guillaumevirgal/autonomous-slam-robot/media/Nav2_2.png

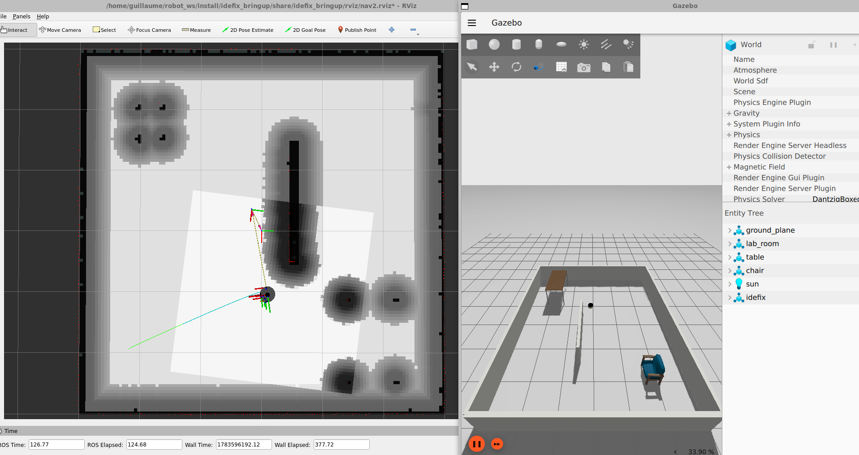
media/Nav2_2.png
