guillaumevirgal/autonomous-slam-robot/README.md

# autonomous-slam-robot
MSc Robotics summer project: an open-source autonomous mobile robot for SLAM, navigation, and perception. Target: HardwareX publication.
