guillaumevirgal/autonomous-slam-robot/media/Nav2_1.png

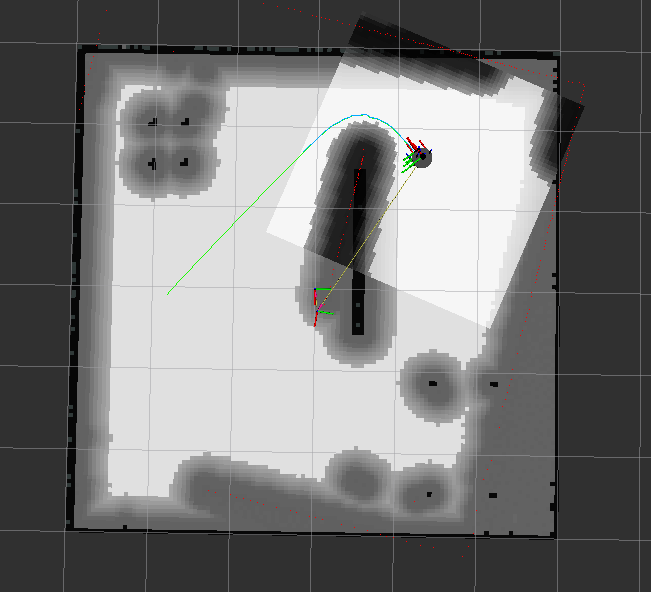
media/Nav2_1.png
