guillaumevirgal/autonomous-slam-robot/hardware/CAD/standoff.stl

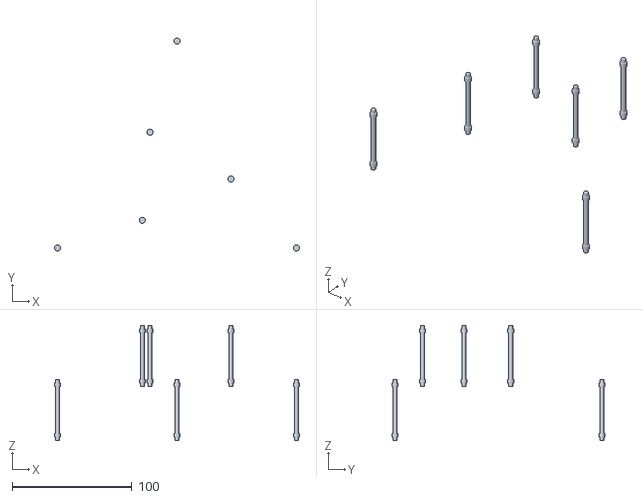
[picture p3: CAD file, 2026-08-01]
hardware/CAD/standoff.stl
204.3 x 177.6 x 96.0
