guillaumevirgal/autonomous-slam-robot/hardware/CAD/deck_3.stl

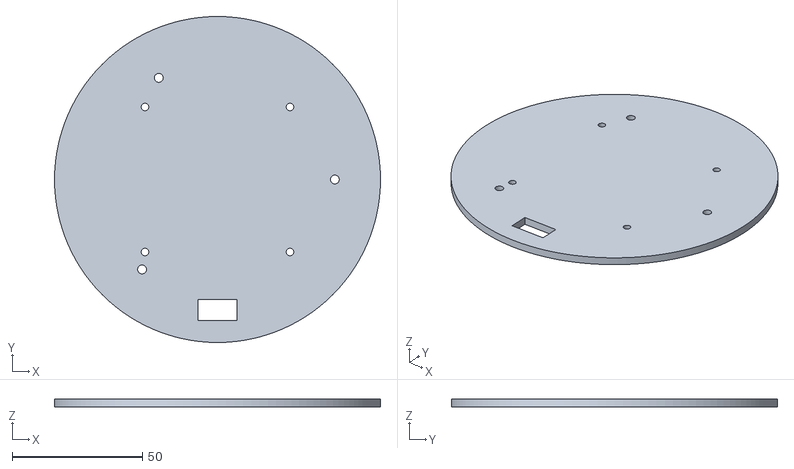
[picture p4: CAD file, 2026-08-01]
hardware/CAD/deck_3.stl
125.0 x 125.0 x 3.00
