guillaumevirgal/autonomous-slam-robot/hardware/CAD/deck_1.stl

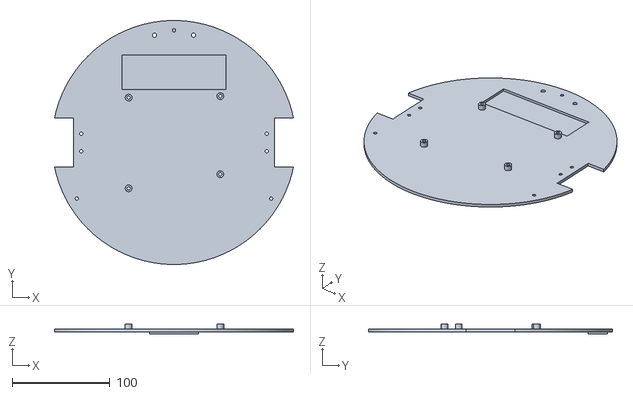
[picture p5: CAD file, 2026-08-01]
hardware/CAD/deck_1.stl
244.9 x 250.0 x 10.0
