guillaumevirgal/autonomous-slam-robot/hardware/CAD/deck_2.stl

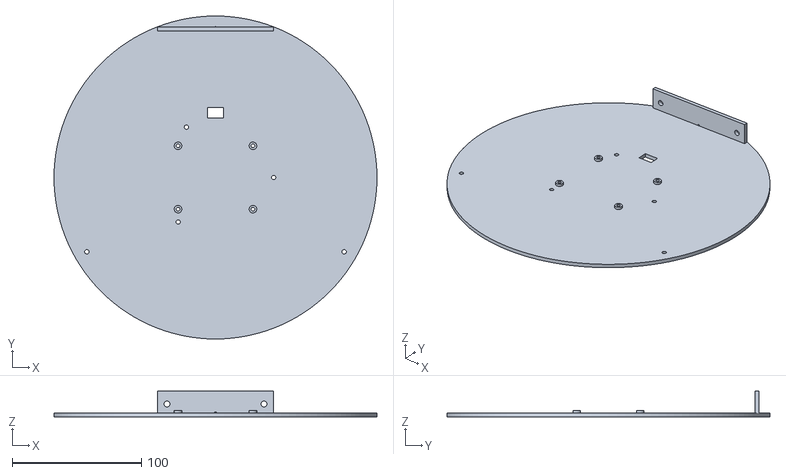
[picture p6: CAD file, 2026-08-01]
hardware/CAD/deck_2.stl
250.0 x 250.0 x 20.0
