guillaumevirgal/autonomous-slam-robot/hardware/PCB/Schematic_Summer-project-autonomous-slam-robot_2026-06-16.pdf

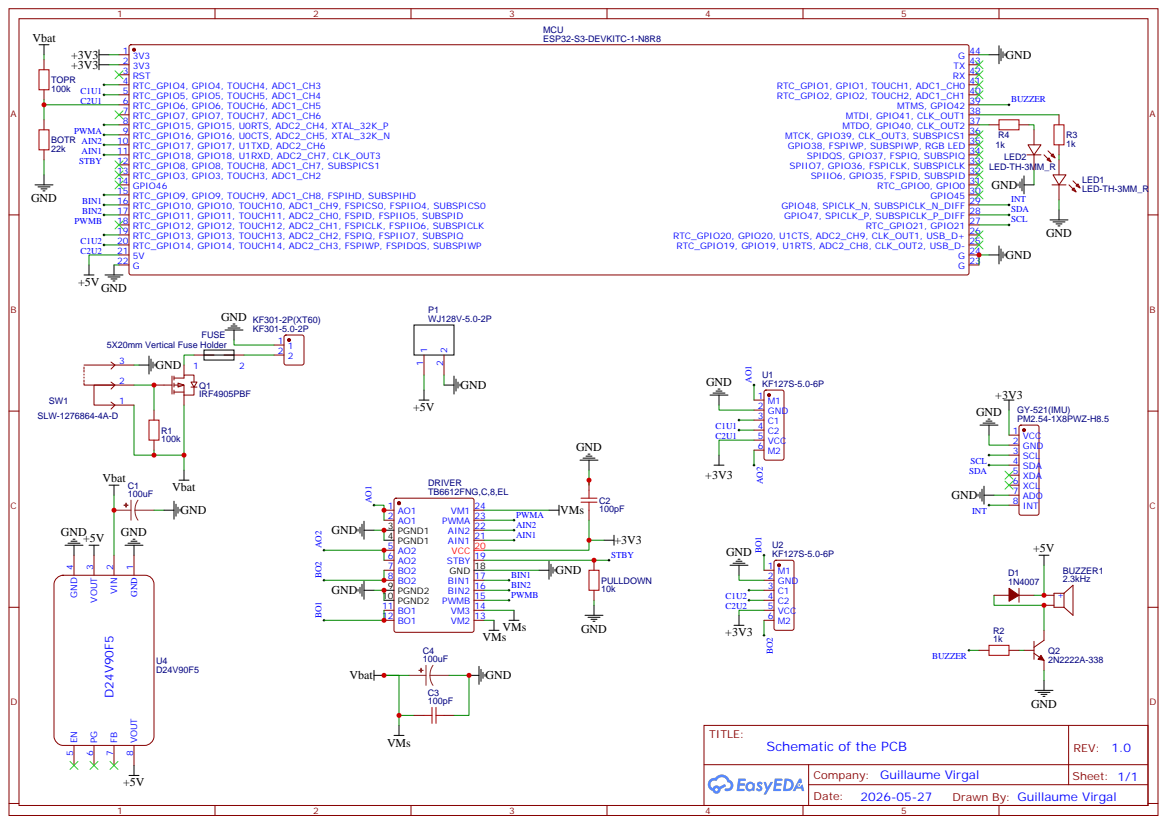
[picture p7: page 1]

MTCK, GPIO39, CLK_OUT3, SUBSPICS1 36
GPIO38, FSPIWP, SUBSPIWP, RGB LED 35
SPIDQS, GPIO37, FSPIQ, SUBSPIQ 34
SPIIO7, GPIO36, FSPICLK, SUBSPICLK 33
SPIIO6, GPIO35, FSPID, SUBSPID 32

Drawn By: Guillaume Virgal
