guillaumevirgal/autonomous-slam-robot/idefix_firmware/main/esp32_serial_transport.h

#ifndef _IDEFIX_ESP32_SERIAL_TRANSPORT_H_
#define _IDEFIX_ESP32_SERIAL_TRANSPORT_H_

#include <stdbool.h>
#include <stddef.h>
#include <stdint.h>

// Forward declaration to avoid pulling in the full micro-XRCE-DDS client header for callers who only need the function prototypes.
struct uxrCustomTransport;

#ifdef __cplusplus
extern "C"
{
#endif

bool   esp32_serial_open (struct uxrCustomTransport * transport);
bool   esp32_serial_close(struct uxrCustomTransport * transport);
size_t esp32_serial_write(struct uxrCustomTransport * transport, const uint8_t * buf, size_t len, uint8_t * err);
size_t esp32_serial_read (struct uxrCustomTransport * transport, uint8_t * buf, size_t len, int timeout, uint8_t * err);

#ifdef __cplusplus
}
#endif

#endif // _IDEFIX_ESP32_SERIAL_TRANSPORT_H_
