guillaumevirgal/autonomous-slam-robot/(commit log)

2026-07-09 Restructuration and add Idefix Phase 1: sim SLAM + Nav2 working, ROS2 packages, maps, media
    [idefix.gazebo.xacro, idefix.urdf.xacro, idefix_lab.sdf, idefix_world.sdf]
2026-08-01 hardware/CAD: OpenSCAD three-deck chassis and standoffs
    Parametric OpenSCAD sources for the circular differential-drive chassis:
    three PLA decks with standoff columns and pedestal for the caster ball.
    STL exports included so reviewers can print without regenerating.
    [Idefix.scad, common.scad, deck_1.scad, deck_1.stl, deck_2.scad, deck_2.stl, deck_3.scad, deck_3.stl]
2026-08-01 hardware/bench_tools: ESP32-C3 logic analyzer 24 MHz validation test
2026-08-01 idefix_firmware: ESP32-S3 firmware, Stage 1 open-loop motor characterization
    ESP-IDF project for the Idefix ESP32-S3-DevKitC-1-N8R8 firmware.
    Stage 1 open-loop motor characterization: PCNT quadrature encoder driver
    and TB6612FNG motor control, duty-sweep test rig.
    Awaiting replacement ESP32 module before re-verification.
    [encoder.c, encoder.h, main.c, motor.c, motor.h, pid.c, pid.h, pins.h]
2026-08-03 Nav2 Fortress -> harmonic migration
    [idefix.gazebo.xacro, idefix_lab.sdf, idefix_world.sdf]
2026-08-09 idefix_firmware: sign convention fixes for open-loop dual motor test
    - motor.c: Motor A invert_direction=true (mirror-symmetric wiring)
    - encoder.c: per-encoder invert parameter, encoder A invert=true
    Verified: positive duty produces positive measured velocity on both motors,
    magnitudes match Stage 1 baseline (2.7 rad/s +/- quantization dither).
    Ready for Stage 2 PID work.
    [encoder.c, main.c, motor.c]
2026-08-09 idefix_firmware: Stage 1 deadband ramp characterization
    25-step staircase, 0.01 duty per step, 2s per level, both motors
    commanded together. Full positive then negative ramp, 100s total.
    Deadband results (breakaway duty):
    - Motor A: +0.040 pos, -0.060 neg
    - Motor B: +0.060 pos, -0.060 neg
    Motor A slightly asymmetric (~20 mDuty). Both motors symmetric at
    cruise (duty >= 0.070). Steady-state at duty=0.15 matches Stage 1
    baseline (~2.75 rad/s). Max at duty=0.24 gives ~4.6 rad/s.
    One glitchy sample at t=89001 (-4491 rad/s spike) confirms need for
    Stage 2 moving-average filter before PID input.
    [main.c]
2026-08-14 idefix_firmware: vendor micro_ros_espidf_component (jazzy, 16cf0d5)
    Adds micro-ROS as a git submodule under components/ pinned to the jazzy
    branch at commit 16cf0d5. Enables Stage 3 (micro-ROS integration) to
    build against a reproducible micro-ROS + Micro XRCE-DDS stack cross-
    compiled for xtensa-esp32s3-elf inside the ESP-IDF build.
    Also commits:
    - dependencies.lock: resolved ESP-IDF component-manager dependencies,
    needed for reproducible builds.
    - sdkconfig: menuconfig state selecting 'micro-ROS over eProsima Micro
    XRCE-DDS' as middleware and 'Micro XRCE-DDS over UART' as network
    interface (defines CONFIG_MICRO_ROS_ESP_UART_TRANSPORT=y).
    Known submodule state: an in-tree edit to
    co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
2026-08-14 idefix_firmware: Stage 3 micro-ROS integration
    Full-rewrite of main.c to add micro-ROS on top of the working Stage 2
    PID loop, with a two-task FreeRTOS design that shares six stdatomic
    variables (setpoints uros->control, encoder snapshots control->uros)
    and no mutexes. control_task at 100 Hz on core 1 remains functionally
    identical to Stage 2; uros_task runs the micro-ROS executor on core 0.
    New source files:
    - esp32_serial_transport.c/h: custom UART transport for micro-ROS.
    Copied from int32_publisher_custom_transport example, modified to
    use UART GPIO pins from pins.h (GPIO 43/44 on ESP32-S3). Wired into the executor via rmw_uros_set_custom_transport
    in app_main.
    - robot_kinematics.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
2026-08-23 Adds odom_tf_broadcaster: subscribes to /odom (nav_msgs/Odometry) and publishes odom -> base_link on /tf via tf2_ros. Verified in isolation on WSL with a fake /odom publisher.
2026-08-25 firmware: micro-ROS serial link verified end to end
    - main.c: explicit rcl_init_options_set_domain_id(94);
    rmw_microxrcedds_c hardcodes domain to 0 regardless of CMake flags
    - app-colcon.meta: already set RMW_UXRCE_TRANSPORT=custom (pre-existing;
    now committed rather than lying around untracked)
    - sdkconfig: flash size 2MB -> 8MB to match N8R8 physical flash
    - .gitignore: exclude build.log
    Verified: /odom flows at 30.3 Hz, 19 ms stamp latency, live tf on
    hand-rotated wheels.
2026-09-01 idefix_bringup: RPLiDAR C1 bringup launch
    Adds launch/rplidar_c1.launch.py: starts the sllidar_ros2 driver node
    plus a static TF from base_link to laser. Publishes /scan at ~10 Hz,
    matching the C1's nominal scan rate.
    Driver: uses sllidar_ros2 (source build via submodule), not the
    originally planned ros-jazzy-rplidar-ros (apt, v2.1.0 is the only
    version available for Jazzy, not v2.1.4 as expected). The apt package
    reads generic device info (S/N, firmware, health) correctly but cannot
    start the C1's motor: scan-start consistently times out
    (RESULT_OPERATION_TIMEOUT) across every scan_mode/auto_standby
    combination and two different USB ports, and the motor was confirmed
    visually to never spin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
2026-09-23 idefix_firmware: IMU bring-up complete (GY-521/MPU6500, driver module, 100 Hz task, micro-ROS publish)
    Replaces the scratch I2C bring-up scan with a permanent imu.c/imu.h
    module mirroring motor.c/encoder.c: init (wake, WHO_AM_I, boot-time
    200-sample gyro bias calibration) and a read function returning
    physical units. A dedicated 100 Hz imu_task (core 0, priority 4)
    samples continuously; uros_task publishes sensor_msgs/Imu on
    /imu/data_raw via its own 100 Hz timer, matching the existing /odom
    pattern so only uros_task touches rcl_* calls. Removing the scratch
    code's infinite halt loop lets the rest of the firmware (motors,
    encoders, micro-ROS) boot normally again.
    Verified end to end on hard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
    [imu.c, imu.h, main.c]
2026-09-23 imu: raise FreeRTOS tick rate, switch /imu/data_raw to best-effort QoS
    Measured /imu/data_raw baseline was 78-84 Hz against the 100 Hz target,
    not the ~35 Hz previously assumed (that figure was stale, from before
    the prior commit's vTaskDelayUntil sampling fix landed). Root cause is
    two factors in uros_task's shared rclc executor (cmd_vel sub, odom
    timer, imu timer, one spin loop):
    1. CONFIG_FREERTOS_HZ was 100 (10 ms tick), so the executor spin
    loop's trailing vTaskDelay(pdMS_TO_TICKS(1)) rounded up to a full
    10 ms delay instead of 1 ms, capping the loop's own cadence.
    Raised to 1000 for 1 ms tick resolution. Measured effect alone:
    reduces period jitter tail, max period 27-29 m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
    [main.c]
2026-09-23 firmware: battery voltage sense (GPIO6/ADC1) + low-voltage buzzer (GPIO42)
    New battery.c/battery.h module, mirroring the existing motor.c/encoder.c/
    imu.c driver-per-file convention. Reads pack voltage over a resistor
    divider (100k top, 22k bottom) into ADC1 channel 5 (GPIO6), with
    per-chip calibration via adc_cali when available and a nominal
    3.3V/4095 fallback when not. Drives an active buzzer on GPIO42 directly
    (no PWM, the buzzer has its own oscillator).
    New battery_task (2 Hz, priority 2, lowest of the four tasks, core 0)
    polls voltage and applies hysteresis: buzzer on at or below 10.0V, off
    again only at or above 10.3V, to avoid chattering right at a single
    threshold from ordinary ADC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
    [battery.c, battery.h, main.c, pins.h]
2026-09-23 idefix_bringup: robot_localization EKF fusing /odom and /imu/data_raw
    New ekf.yaml + ekf.launch.py, launching robot_localization's ekf_node
    against the existing ament_python data_files globs (no setup.py change
    needed, launch/*launch.py and config/*.yaml already glob generically).
    Fuses body-frame velocities only, not pose: vx and vyaw from /odom, vyaw
    only from /imu/data_raw. Not fusing linear acceleration from the
    MPU6500 clone at this stage, it is noisy and uncalibrated. two_d_mode
    true (planar differential drive). process_noise_covariance left at
    defaults, tuning deferred until the fused estimate is stable.
    Correction to the original plan: it assumed firmware owned the
    odom -> base_lin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
    [ekf.yaml]
2026-09-23 idefix_firmware: best-effort cmd_vel QoS + micro-ROS agent retry
    Two independent fixes to main.c, found and applied during the Phase 3
    audit and SLAM mapping bringup.
    cmd_vel QoS: rclc_subscription_init_default (RELIABLE) is replaced with
    rclc_subscription_init_best_effort. The comment directly above the call
    already claimed best-effort ("matches teleop_twist_keyboard and Nav2
    defaults"); the code just never matched it.
    Agent handshake retry: RCCHECK on rclc_support_init_with_options called
    vTaskDelete(NULL) on failure, permanently killing uros_task with no
    retry. In practice this meant the micro-ROS agent had to already be
    running before the ESP32 booted, or the only way to get a fresh
    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
    [main.c]
2026-09-23 idefix_bringup + idefix_description: fix TF tree conflicts, scan yaw
    Two TF conflicts found and fixed while wiring up robot_state_publisher
    alongside the hardware LiDAR launch for the first time (previously
    never run together, so these were latent, not active, until now).
    base_footprint / base_link: odom_tf_broadcaster.py published
    odom -> base_link directly, but the URDF has base_footprint as
    base_link parent via a fixed joint (REP-105 pattern), so both were
    claiming to be base_link parent. Retargeted odom_tf_broadcaster.py to
    publish odom -> base_footprint instead. x/y/yaw are unaffected since
    they come straight from wheel-encoder odometry either way; only z
    differs between the two frames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
    [idefix.gazebo.xacro, idefix.urdf.xacro]
2026-09-23 idefix_bringup: hardware SLAM mapping launch
    Adds slam_mapping.launch.py and slam_toolbox_mapping.yaml: the LiDAR,
    robot_state_publisher, odom_tf_broadcaster, and slam_toolbox in
    mapping mode (as opposed to the existing slam_toolbox_localization.yaml,
    which is sim-era, localization mode, use_sim_time true, no map even
    configured). Mapping config values are adapted from the already-working
    sim slam_toolbox.yaml, changed to use_sim_time false.
    async_slam_toolbox_node turned out to be a lifecycle node in the
    installed version (2.8.5) even though it is the plain/non-Nav2
    executable. Launched as an ordinary Node it just sat unconfigured
    forever: zero subscriptions, no /map, no error, total silen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
2026-09-23 idefix_firmware: fix two cross-core races causing spurious /odom velocity spikes
    Found while diagnosing a rotation test that intermittently reported
    odom/filtered agreeing on rotation amounts wildly exceeding what was
    commanded (up to ~200% of a commanded 360 deg turn), with single /odom
    angular-velocity samples spiking to ~200-290 rad/s -- physically
    impossible for this drivetrain.
    1. main.c odom_timer_callback: the encoder snapshot (g_snapshot_counts_a,
    g_snapshot_counts_b, g_snapshot_time_us) was three independent atomics,
    written as a group by control_task and read as a group by
    odom_timer_callback, with a comment reasoning this was fine ("at worst
    ~10ms of temporal skew, in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
    [encoder.c, main.c]
2026-09-23 docs: bringup log for EKF deployment and left-wheel bolt diagnosis
    Starts docs/hardware_bringup.md (previously empty) with the first real
    hardware run of the robot_localization EKF: micro-ROS agent baud rate was
    stale (921600, not the documented 460800), a systemd-logind
    KillUserProcesses setting was reaping tmux/background processes between
    SSH sessions (fixed with loginctl enable-linger), and a rotation-test
    methodology for measuring commanded vs. achieved rotation via /odom and
    /odometry/filtered.
    Root-caused a reproducible ~50% rotation shortfall to the left wheel
    (Motor A) intermittently under-driving relative to the right wheel: for a
    pure in-place rotation both wheels normally contri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
2026-09-24 docs: bringup log for online SLAM + Nav2 on hardware
    Nav2 install on the Pi, slam_nav bringup verification, the use_sim_time
    override bug and its fix, and the open goal-following stall issue.
2026-09-24 idefix_firmware: stop double-counting PCNT overflows in encoder.c
    accum_count = true makes the ESP-IDF 5.3 PCNT driver accumulate +/-30000
    on each watch-point hit and return hw + accum_value from
    pcnt_unit_get_count(). The on_reach callback also added watch_point_value
    to a software accumulator, so every overflow was counted twice: a
    permanent 30000-count (~0.99 m) jump on one wheel each time its net count
    crossed +/-30000. This is the ~200-290 rad/s /odom spike and ~132 deg pose
    jump (30000 counts -> 8.585 rad -> 131.9 deg wrapped).
    Drop the callback and software accumulator and return the driver's
    extended count. Verified on hardware: two 4-turn spins crossing an
    overflow, odom 99.2% of c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
2026-09-24 docs: root cause of the /odom spike (PCNT overflow double count)
    Evidence from the slam_nav bag, the 30000-count arithmetic, the fix and
    flash procedure from the Pi, spin-test verification, and the gyro scale
    side finding.
2026-10-10 idefix_firmware: measured wheel base, quieter low-battery alarm
    WHEEL_BASE_M 0.115 -> 0.230 m (effective track). 0.225 m measured wheel
    centre to centre, scaled by 720/702.8 from a gyro-checked 2-turn spin that
    stopped ~1 deg from a floor mark. The old value made the robot physically
    turn ~0.5x what odom reported, since cmd_vel -> wheel speeds and odom
    integration share the constant.
    Low-battery alarm: two 75 ms beeps every 15 s instead of a continuous
    tone; threshold 10.0 -> 9.5 V (3.17 V/cell under load), clear 9.8 V.
2026-10-10 idefix_bringup: hardware speed limits, SLAM on rotation, LiDAR yaw
    - slam_nav: Nav2 limited to 0.07 m/s and 0.5-0.6 rad/s to match the
    0.24 duty clamp (~0.085 m/s top speed); shared nav2_params.yaml keeps
    the sim tuning. Progress checker radius 0.5 -> 0.25 m.
    - slam_toolbox_mapping: check_min_dist_and_heading_precisely so in-place
    turns trigger scan matching; travel thresholds 0.5 -> 0.2 m / rad.
    - base_link -> laser yaw -8.1 deg, measured by straight-drive ICP
    (launch static TF and URDF lidar_joint).
    - URDF track_width 0.216 -> 0.225 m (measured).
    - slam_mapping docstring: map_saver_cli lives in nav2_map_server.
2026-10-10 docs: 2026-09-28 rotation, SLAM and LiDAR calibration bringup log
    Wheel base, slam_toolbox heading gate, LiDAR yaw and Nav2 speed limits,
    each with the bag and test that found and verified it. Corrects the
    2026-09-24 gyro-scale diagnosis and the circular 99.2% spin check.
2026-10-19 idefix_firmware: track gyro bias while the robot is still
    The boot-time gyro bias goes stale as the IMU warms up (~1 deg/min
    residual measured ~15 min after reset), which the EKF turns into heading
    drift while parked since it trusts the gyro over the wheels for yaw rate.
    control_task flags standstill once both wheels are commanded to coast and
    measured stopped for 1 s; imu_task then folds each sample into the bias
    (tau 20 s), skipping samples above 1 deg/s so a hand-carried robot is not
    absorbed as bias. Parked EKF yaw over 10 min: -0.23 deg (was ~-6 deg).
2026-10-19 idefix_bringup: EKF as default odom source, hardware RViz config
    - slam_mapping/slam_nav: use_ekf (default true) starts the
    robot_localization EKF instead of odom_tf_broadcaster for
    odom -> base_footprint. Floor test: SLAM net yaw correction <= 1.6 deg
    per goal, -0.2 deg over a 717 deg spin.
    - ekf.yaml: base_link_frame base_footprint (URDF owns base_footprint ->
    base_link), frequency 30 Hz to stop deadline misses under CPU load.
    - rviz.launch.py + rviz/slam_nav.rviz: costmaps, map, plan and scan with
    the QoS and colours preset for the real robot.
2026-10-19 docs: 2026-10-19 EKF integration and gyro bias tracking log
    Offline wheel-slip replay, parked drift before/after bias tracking, the
    standstill gate tests and the floor run. Also records the open ESP32
    timestamp issue after a Pi cold boot (NTP step after the micro-ROS sync).
2026-10-19 idefix_firmware: re-sync the clock with the agent every 10 s
    The Pi has no RTC, and NTP steps its clock minutes after a cold boot,
    after the ESP32's one-time sync at the micro-ROS handshake. /odom and
    /imu/data_raw then stayed stamped ~2 min in the past, so slam_toolbox
    dropped every scan and Nav2 bringup aborted. Re-syncing every 10 s
    (100 ms timeout) bounds the bad-stamp window to 10 s; steps above 10 ms
    are logged. Verified with +60 s and -60 s clock steps on the Pi.
2026-10-19 docs: explain inline instead of pointing to an untracked file
    The bringup log and rviz.launch.py referred readers to a root
    instruction file that is not part of the repository. State the reasons
    directly: the Pi runs from the robot's LiPo, and outbound UDP from WSL2
    never reaches the Pi's LAN.
2026-10-19 idefix_bringup: tune Nav2 path following on hardware
    Fixed 0.35 m lookahead instead of the velocity-scaled one (clamped at
    0.2 m at 0.07 m/s), cost-regulated slowdown off, approach slowdown from
    0.3 m, goal tolerance 0.10 m, planner tolerance 0.15 m. Over 3 goals:
    rotate-in-place time 41% -> 3-13%, cruise 0.05 -> 0.067 m/s, final
    position error 20 -> 9 cm.
